thongthach/ASME/submarine_control_board/bruin_underwater.jpg

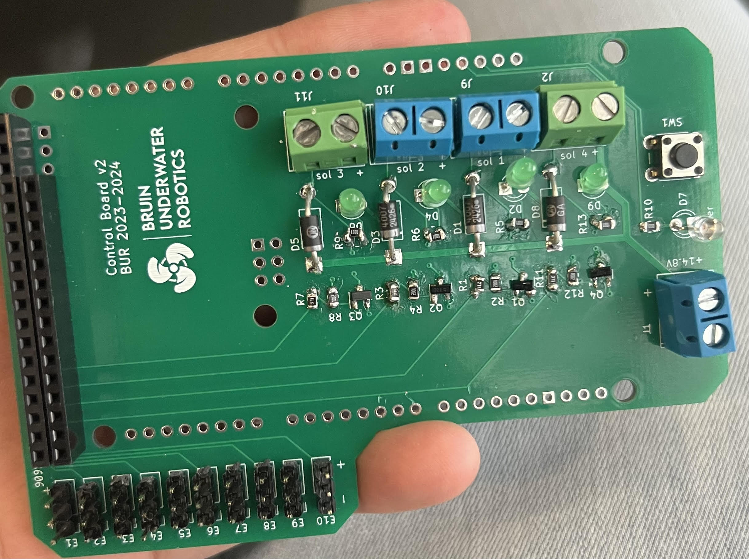
submarine_control_board/bruin_underwater.jpg
