thongthach/ASME/battery_monitoring_designPCB/pcb/battery monitoring board.kicad_pcb

## KiCad design battery_monitoring_designPCB/pcb/battery monitoring board.kicad_pcb (2025-06-21)

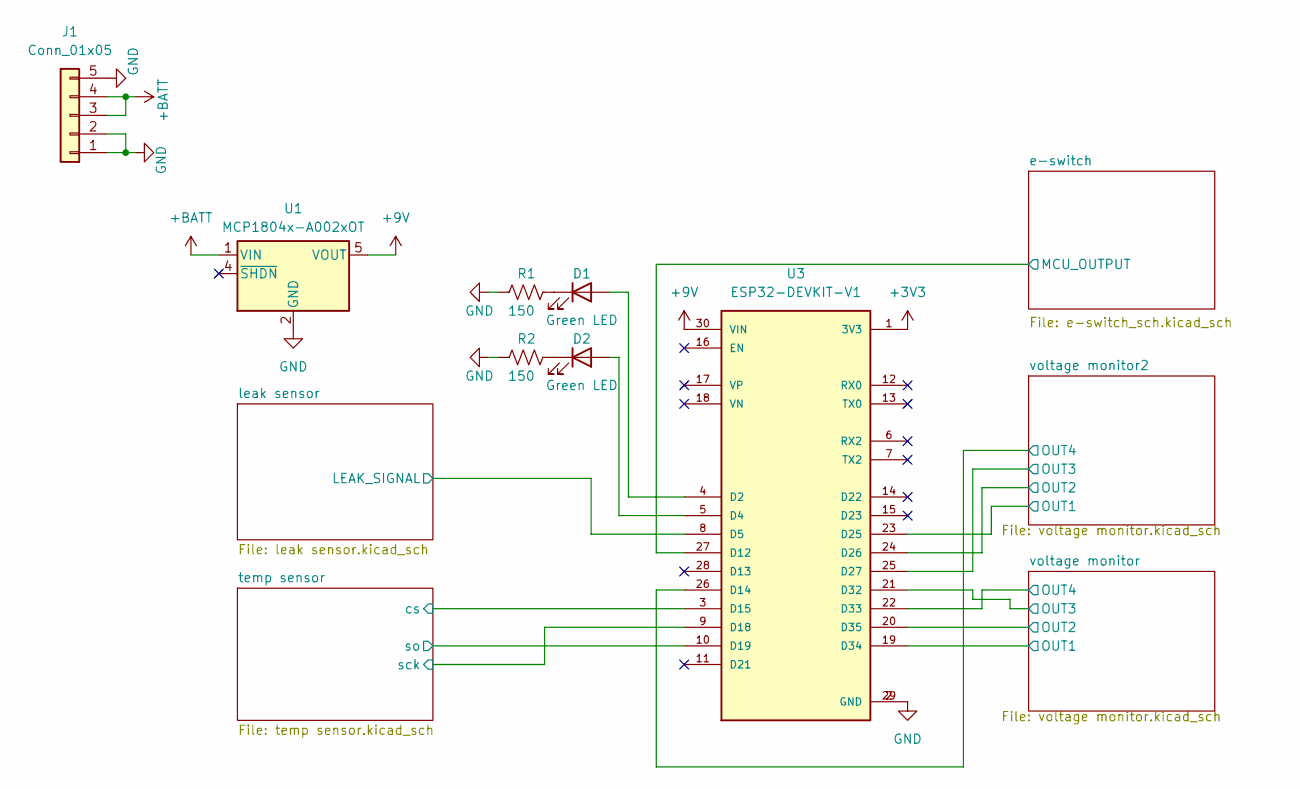
[picture p2: schematic battery monitoring board.kicad_sch]

Parts:
D1, D2: Green LED; D_0805_2012Metric_Pad1.15x1.40mm_HandSolder
J1: Conn_01x05; 1x5 Screw, 39970-0105 MOLEX
R1, R2: 150; R_0805_2012Metric_Pad1.20x1.40mm_HandSolder
U1: MCP1804x-A002xOT; SOT-23-5
U3: ESP32-DEVKIT-V1; MODULE_ESP32_DEVKIT_V1; PARTREV N/A

Connections:
+3V3: U3.1 (3V3); also elsewhere on the board
+9V: U1.5 (VOUT), U3.30 (VIN); also elsewhere on the board
+BATT: J1.3, J1.4, U1.1 (VIN); also elsewhere on the board
/e-switch/MCU_OUTPUT: U3.27 (D12); also elsewhere on the board
/leak sensor/LEAK_SIGNAL: U3.8 (D5); also elsewhere on the board
/temp sensor/cs: U3.3 (D15); also elsewhere on the board
/temp sensor/sck: U3.9 (D18); also elsewhere on the board
/temp sensor/so: U3.10 (D19); also elsewhere on the board
/voltage monitor2/OUT1: U3.23 (D25); also elsewhere on the board
/voltage monitor2/OUT2: U3.24 (D26); also elsewhere on the board
/voltage monitor2/OUT3: U3.25 (D27); also elsewhere on the board
/voltage monitor2/OUT4: U3.26 (D14); also elsewhere on the board
/voltage monitor/OUT1: U3.19 (D34); also elsewhere on the board
/voltage monitor/OUT2: U3.20 (D35); also elsewhere on the board
/voltage monitor/OUT3: U3.21 (D32); also elsewhere on the board
/voltage monitor/OUT4: U3.22 (D33); also elsewhere on the board
GND: J1.1, J1.2, J1.5, R1.1, R2.1, U1.2 (GND), U3.2 (GND), U3.29 (GND); also elsewhere on the board
unnamed: D1.2 (A), U3.4 (D2)
unnamed: D1.1 (K), R1.2
unnamed: D2.2 (A), U3.5 (D4)
unnamed: D2.1 (K), R2.2

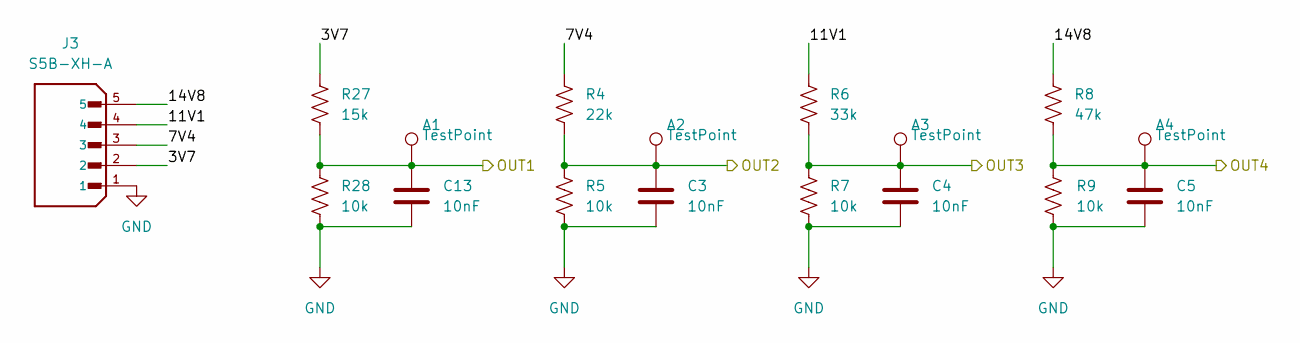
[picture p3: schematic voltage monitor.kicad_sch]

Parts:
A1, A2, A3, A4: TestPoint; TestPoint_Pad_1.0x1.0mm
C3, C4, C5, C13: 10nF; C_0805_2012Metric_Pad1.18x1.45mm_HandSolder
J3: S5B-XH-A; JST_S5B-XH-A; PARTREV 27-1-20
R4: 22k; R_0805_2012Metric_Pad1.20x1.40mm_HandSolder
R5, R7, R9, R28: 10k; R_0805_2012Metric_Pad1.20x1.40mm_HandSolder
R6: 33k; R_0805_2012Metric_Pad1.20x1.40mm_HandSolder
R8: 47k; R_0805_2012Metric_Pad1.20x1.40mm_HandSolder
R27: 15k; R_0805_2012Metric_Pad1.20x1.40mm_HandSolder

Connections:
/voltage monitor/3V7: J3.2, R27.2
/voltage monitor/7V4: J3.3, R4.2
/voltage monitor/11V1: J3.4, R6.2
/voltage monitor/14V8: J3.5, R8.2
/voltage monitor/OUT1: A1.1, C13.1, R27.1, R28.1; also elsewhere on the board
/voltage monitor/OUT2: A2.1, C3.1, R4.1, R5.1; also elsewhere on the board
/voltage monitor/OUT3: A3.1, C4.1, R6.1, R7.1; also elsewhere on the board
/voltage monitor/OUT4: A4.1, C5.1, R8.1, R9.2; also elsewhere on the board
GND: C3.2, C4.2, C5.2, C13.2, J3.1, R5.2, R7.2, R9.1, R28.2; also elsewhere on the board

Parts of its further copies:
B1, B2, B3, B4: TestPoint; TestPoint_Pad_1.0x1.0mm
C10, C11, C12, C14: 10nF; C_0805_2012Metric_Pad1.18x1.45mm_HandSolder
J9: S5B-XH-A; JST_S5B-XH-A; PARTREV 27-1-20
R20: 22k; R_0805_2012Metric_Pad1.20x1.40mm_HandSolder
R21, R23, R25, R30: 10k; R_0805_2012Metric_Pad1.20x1.40mm_HandSolder
R22: 33k; R_0805_2012Metric_Pad1.20x1.40mm_HandSolder
R24: 47k; R_0805_2012Metric_Pad1.20x1.40mm_HandSolder
R29: 15k; R_0805_2012Metric_Pad1.20x1.40mm_HandSolder

Connections of its further copies:
/voltage monitor2/3V7: J9.2, R29.2
/voltage monitor2/7V4: J9.3, R20.2
/voltage monitor2/11V1: J9.4, R22.2
/voltage monitor2/14V8: J9.5, R24.2
/voltage monitor2/OUT1: B1.1, C14.1, R29.1, R30.1; also elsewhere on the board
/voltage monitor2/OUT2: B2.1, C10.1, R20.1, R21.1; also elsewhere on the board
/voltage monitor2/OUT3: B3.1, C11.1, R22.1, R23.1; also elsewhere on the board
/voltage monitor2/OUT4: B4.1, C12.1, R24.1, R25.2; also elsewhere on the board
GND: C10.2, C11.2, C12.2, C14.2, J9.1, R21.2, R23.2, R25.1, R30.2; also elsewhere on the board

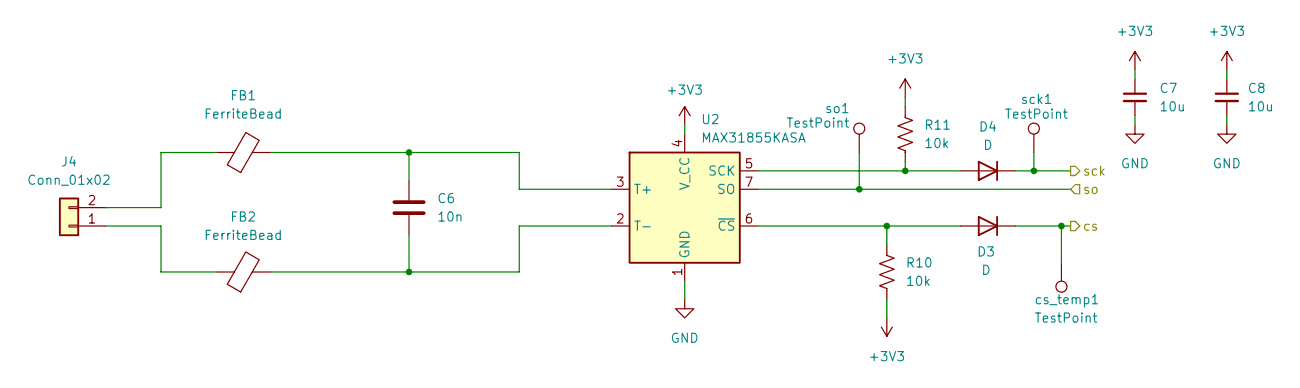
[picture p4: schematic temp sensor.kicad_sch]

Parts:
C6: 10n; C_0805_2012Metric_Pad1.18x1.45mm_HandSolder
C7, C8: 10u; C_0805_2012Metric_Pad1.18x1.45mm_HandSolder
D3, D4: D; D_0805_2012Metric_Pad1.15x1.40mm_HandSolder
FB1, FB2: FerriteBead; C_0805_2012Metric
J4: Conn_01x02; TE_282836-2; Part Number 1-0201FBV0T
R10, R11: 10k; R_0805_2012Metric_Pad1.20x1.40mm_HandSolder
U2: MAX31855KASA; SOIC-8_3.9x4.9mm_P1.27mm
cs_temp1: TestPoint; TestPoint_Pad_1.0x1.0mm
sck1: TestPoint; TestPoint_Pad_1.0x1.0mm
so1: TestPoint; TestPoint_Pad_1.0x1.0mm

Connections:
+3V3: C7.1, C8.1, R10.2, R11.1, U2.4 (V_CC); also elsewhere on the board
/temp sensor/cs: D3.1 (K), cs_temp1.1; also elsewhere on the board
/temp sensor/sck: D4.1 (K), sck1.1; also elsewhere on the board
/temp sensor/so: U2.7 (SO), so1.1; also elsewhere on the board
GND: C7.2, C8.2, U2.1 (GND); also elsewhere on the board
unnamed: D3.2 (A), R10.1, U2.6 (~CS)
unnamed: D4.2 (A), R11.2, U2.5 (SCK)
unnamed: FB2.1, J4.1
unnamed: FB1.1, J4.2
unnamed: C6.1, FB1.2, U2.3 (T+)
unnamed: C6.2, FB2.2, U2.2 (T-)

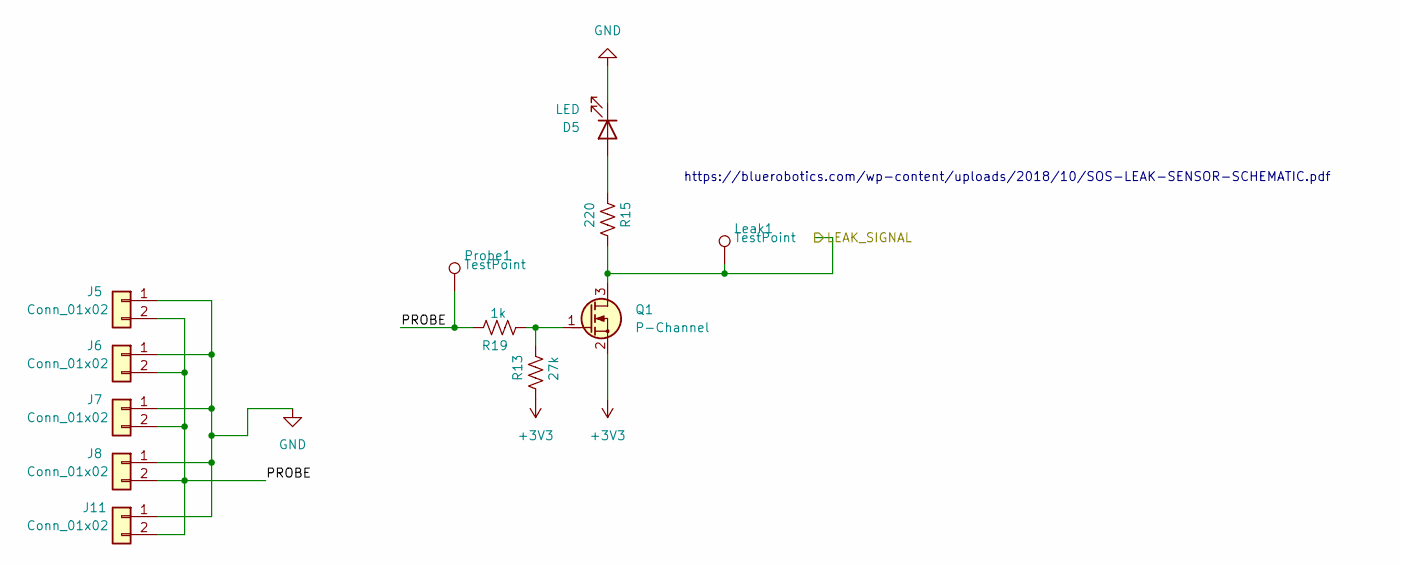
[picture p5: schematic leak sensor.kicad_sch]

Parts:
D5: LED; D_0805_2012Metric_Pad1.15x1.40mm_HandSolder
J5, J6, J7, J8, J11: Conn_01x02; PinHeader_1x02_P1.27mm_Vertical
Leak1: TestPoint; TestPoint_Pad_1.0x1.0mm
Probe1: TestPoint; TestPoint_Pad_1.0x1.0mm
Q1: P-Channel; SOT-23
R13: 27k; R_0805_2012Metric_Pad1.20x1.40mm_HandSolder
R15: 220; R_0805_2012Metric_Pad1.20x1.40mm_HandSolder
R19: 1k; R_0805_2012Metric_Pad1.20x1.40mm_HandSolder

Connections:
+3V3: Q1.2 (S), R13.2; also elsewhere on the board
/leak sensor/LEAK_SIGNAL: Leak1.1, Q1.3 (D), R15.2; also elsewhere on the board
/leak sensor/PROBE: J5.2, J6.2, J7.2, J8.2, J11.2, Probe1.1, R19.1
GND: D5.1 (K), J5.1, J6.1, J7.1, J8.1, J11.1; also elsewhere on the board
unnamed: D5.2 (A), R15.1
unnamed: Q1.1 (G), R13.1, R19.2

Notes on the sheet:
https://bluerobotics.com/wp-content/uploads/2018/10/SOS-LEAK-SENSOR-SCHEMATIC.pdf

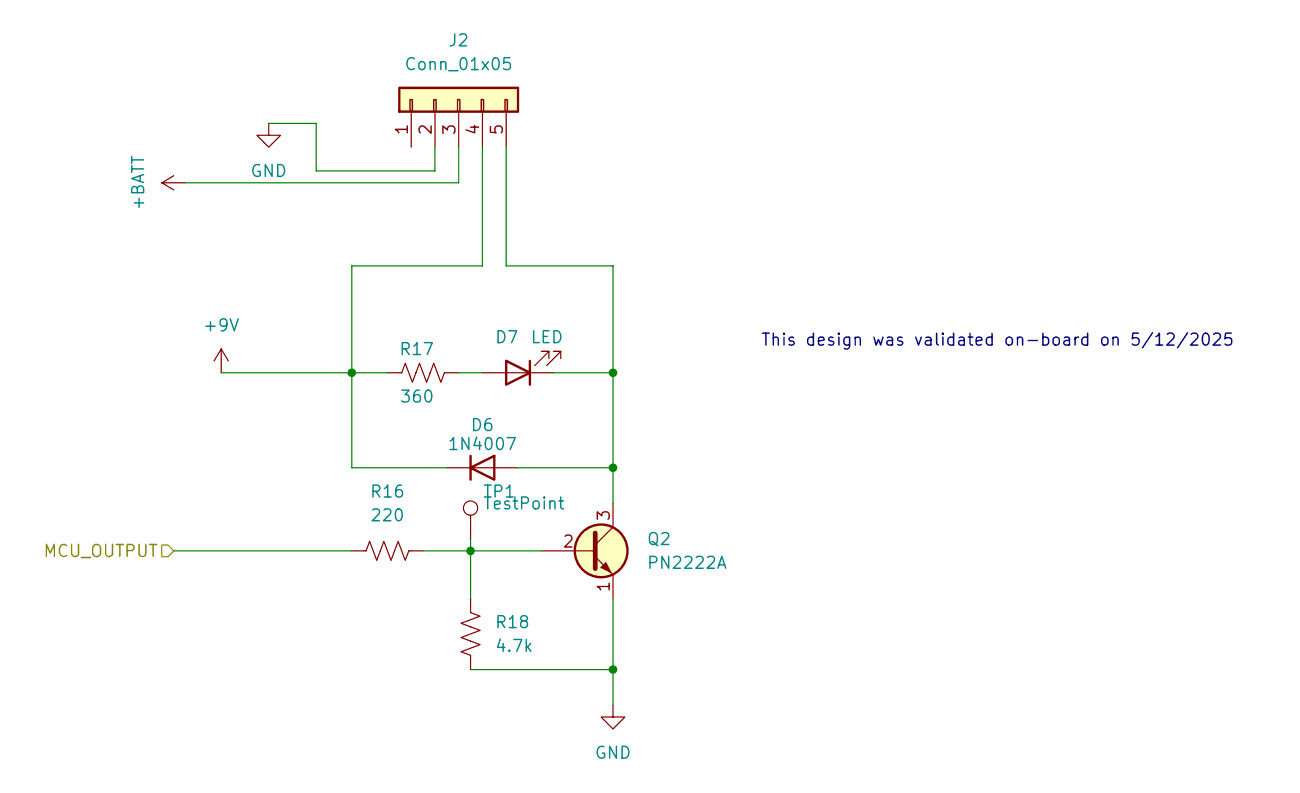
[picture p6: schematic e-switch_sch.kicad_sch]

Parts:
D6: 1N4007; D_SMA
D7: LED; D_0805_2012Metric_Pad1.15x1.40mm_HandSolder
J2: Conn_01x05; 1x5 Screw, 39970-0105 MOLEX
Q2: PN2222A; TO-92
R16: 220; R_0805_2012Metric_Pad1.20x1.40mm_HandSolder
R17: 360; R_0805_2012Metric_Pad1.20x1.40mm_HandSolder
R18: 4.7k; R_0805_2012Metric_Pad1.20x1.40mm_HandSolder
TP1: TestPoint; TestPoint_Pad_1.0x1.0mm

Connections:
+9V: D6.1 (K), J2.4, R17.1; also elsewhere on the board
+BATT: J2.3; also elsewhere on the board
/e-switch/MCU_OUTPUT: R16.1; also elsewhere on the board
GND: J2.2, J2.2A, Q2.1 (E), R18.2; also elsewhere on the board
unnamed: D6.2 (A), D7.1 (K), J2.5, Q2.3 (C)
unnamed: D7.2 (A), R17.2
unnamed: Q2.2 (B), R16.2, R18.1, TP1.1

Notes on the sheet:
This design was validated on-board on 5/12/2025

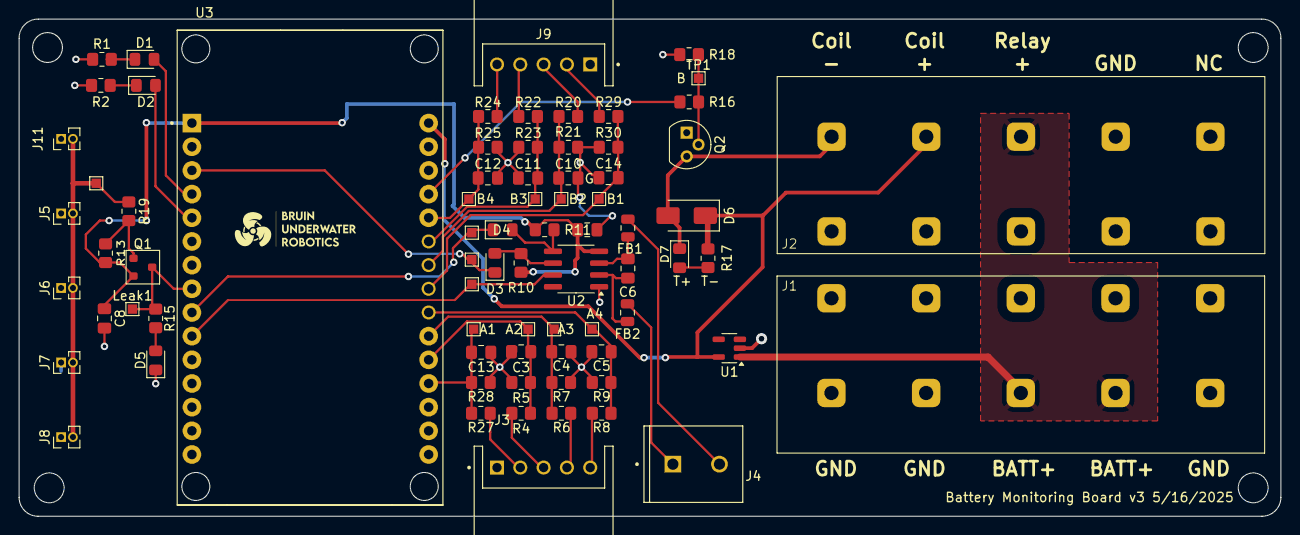
[picture p7: board battery monitoring board.kicad_pcb from above]

Board: 2 copper layers, 135.4 x 53.3 mm, 75 parts (0 on the bottom side), 41 nets.
