thongthach/ASME/control_board_PCB/pcb/control board.kicad_pcb

## KiCad design control_board_PCB/pcb/control board.kicad_pcb (2025-06-21)

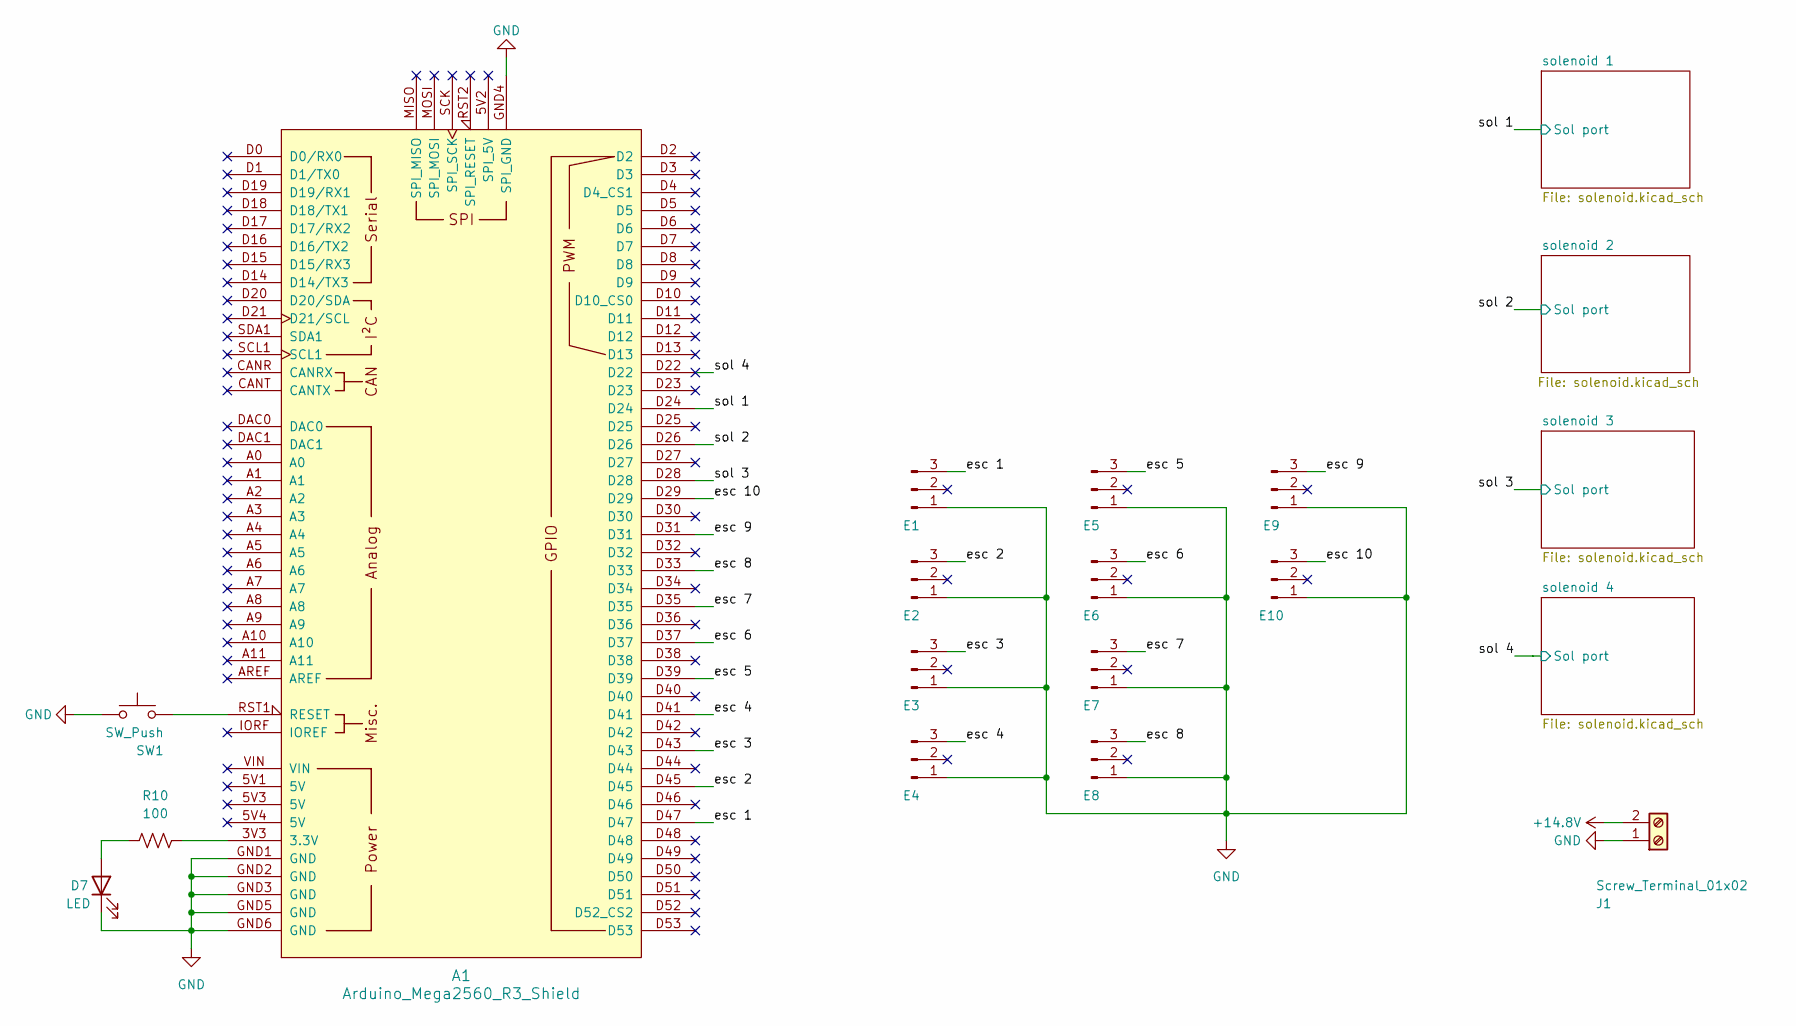
[picture p8: schematic control board.kicad_sch]

Parts:
A1: Arduino_Mega2560_R3_Shield; Arduino_Due_Shield
D7: LED; LED_D3.0mm_Clear
E1, E2, E3, E4, E5, E6, E7, E8, E9, E10: Conn_01x03_Pin; PinHeader_1x03_P2.54mm_Vertical
J1: Screw_Terminal_01x02; TE_282836-2
R10: 100; R_0805_2012Metric
SW1: SW_Push; SW_PUSH_6mm

Connections:
+14.8V: J1.2; also elsewhere on the board
/esc 1: A1.D47, E1.3
/esc 2: A1.D45, E2.3
/esc 3: A1.D43, E3.3
/esc 4: A1.D41, E4.3
/esc 5: A1.D39, E5.3
/esc 6: A1.D37, E6.3
/esc 7: A1.D35, E7.3
/esc 8: A1.D33, E8.3
/esc 9: A1.D31, E9.3
/esc 10: A1.D29, E10.3
/sol 1: A1.D24; also elsewhere on the board
/sol 2: A1.D26; also elsewhere on the board
/sol 3: A1.D28; also elsewhere on the board
GND: A1.GND1 (GND), A1.GND2 (GND), A1.GND3 (GND), A1.GND4 (SPI_GND), A1.GND5 (GND), A1.GND6 (GND), D7.1 (K), E1.1, E2.1, E3.1, E4.1, E5.1, E6.1, E7.1, E8.1, E9.1, E10.1, J1.1, SW1.1; also elsewhere on the board
unnamed: A1.3V3 (3.3V), R10.2
unnamed: A1.RST1 (RESET), SW1.2
unnamed: D7.2 (A), R10.1

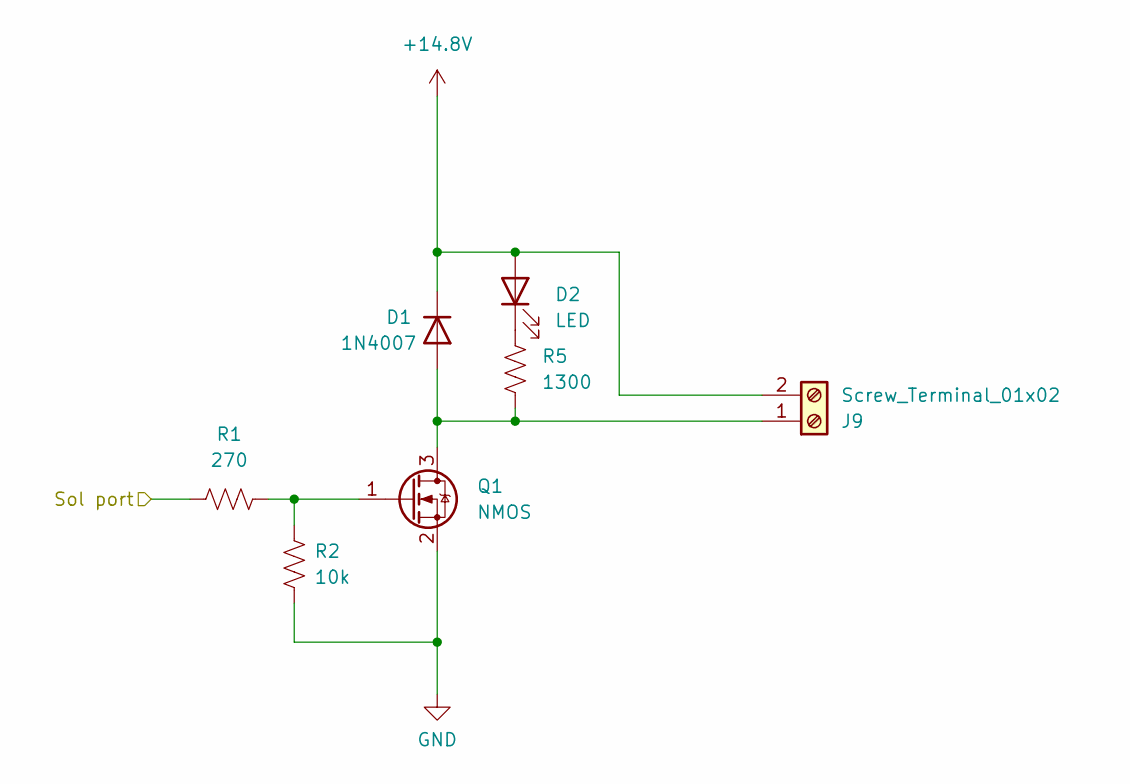
[picture p9: schematic solenoid.kicad_sch]

Parts:
D1: 1N4007; D_DO-41_SOD81_P10.16mm_Horizontal
D2: LED; LED_D3.0mm
J9: Screw_Terminal_01x02; TE_282836-2
Q1: NMOS; SOT-23
R1: 270; R_0805_2012Metric
R2: 10k; R_0805_2012Metric
R5: 1300; R_0805_2012Metric

Connections:
+14.8V: D1.1 (K), D2.2 (A), J9.2; also elsewhere on the board
/sol 1: R1.1; also elsewhere on the board
GND: Q1.2 (S), R2.2; also elsewhere on the board
unnamed: D1.2 (A), J9.1, Q1.3 (D), R5.2
unnamed: D2.1 (K), R5.1
unnamed: Q1.1 (G), R1.2, R2.1

Parts of its further copies:
D3, D5: 1N4007; D_DO-41_SOD81_P10.16mm_Horizontal
D4, D6: LED; LED_D3.0mm
J10, J11: Screw_Terminal_01x02; TE_282836-2
Q2, Q3: NMOS; SOT-23
R3, R7: 270; R_0805_2012Metric
R4, R8: 10k; R_0805_2012Metric
R6, R9: 1300; R_0805_2012Metric

Connections of its further copies:
+14.8V: D3.1 (K), D4.2 (A), D5.1 (K), D6.2 (A), J10.2, J11.2; also elsewhere on the board
/sol 2: R3.1; also elsewhere on the board
/sol 3: R7.1; also elsewhere on the board
GND: Q2.2 (S), Q3.2 (S), R4.2, R8.2; also elsewhere on the board
unnamed: D3.2 (A), J10.1, Q2.3 (D), R6.2
unnamed: D4.1 (K), R6.1
unnamed: D5.2 (A), J11.1, Q3.3 (D), R9.2
unnamed: D6.1 (K), R9.1
unnamed: Q2.1 (G), R3.2, R4.1
unnamed: Q3.1 (G), R7.2, R8.1

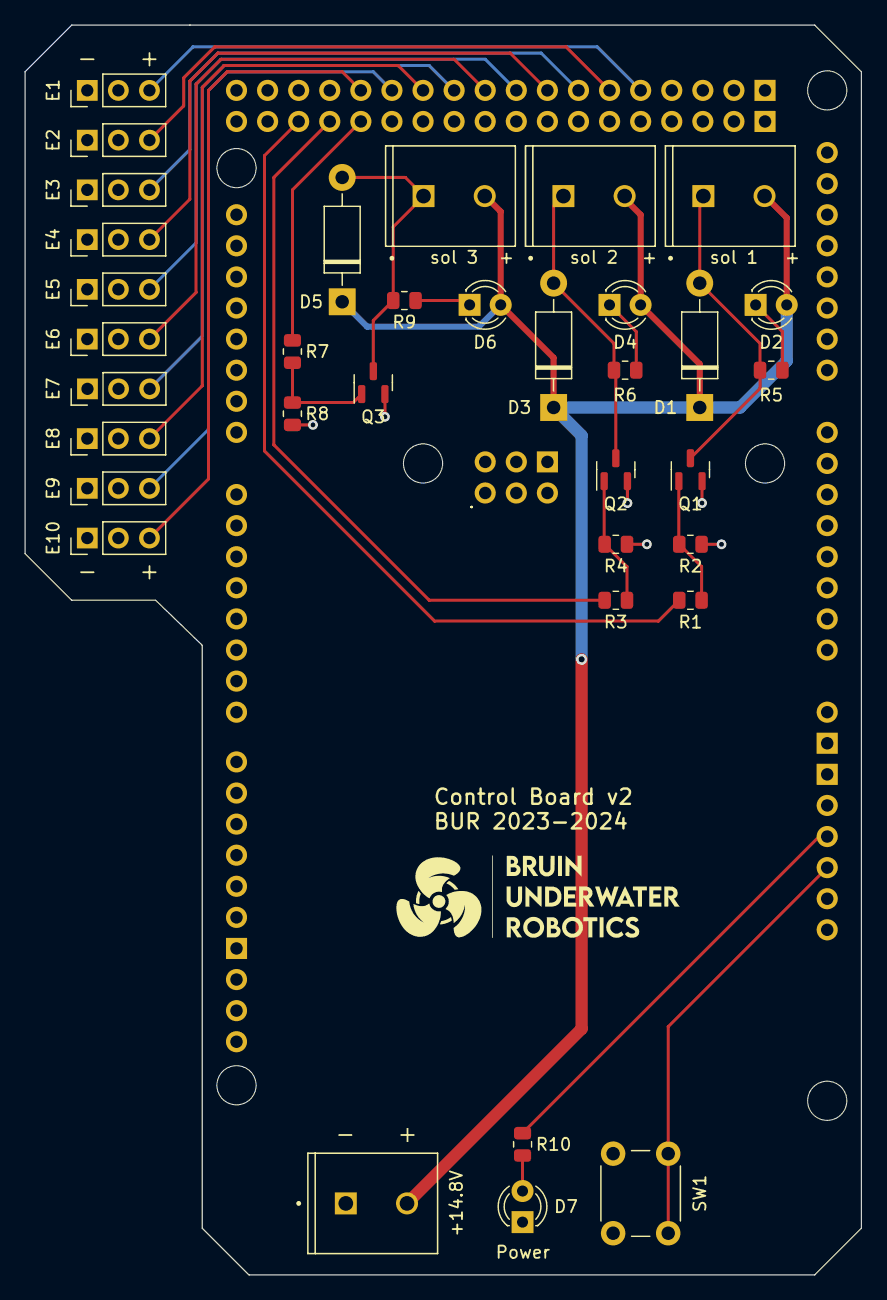
[picture p10: board control board.kicad_pcb from above]

Board: 2 copper layers, 68.3 x 102.1 mm, 36 parts (0 on the bottom side), 27 nets.
